sourav-kanta/minimal_watch_hw/ext_kicad_models/DW01A/DW01A.step

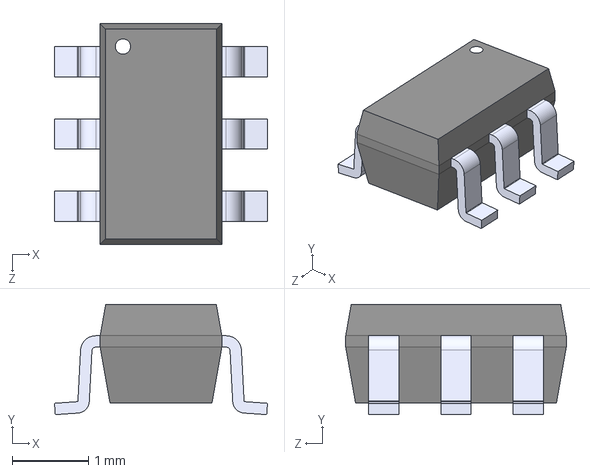
[picture p1: CAD file, 2026-02-19]
ext_kicad_models/DW01A/DW01A.step
2.80 x 1.45 x 2.90 mm
