sourav-kanta/minimal_watch_hw/ext_kicad_models/EC11B-SW-Horiz-15F-black.step

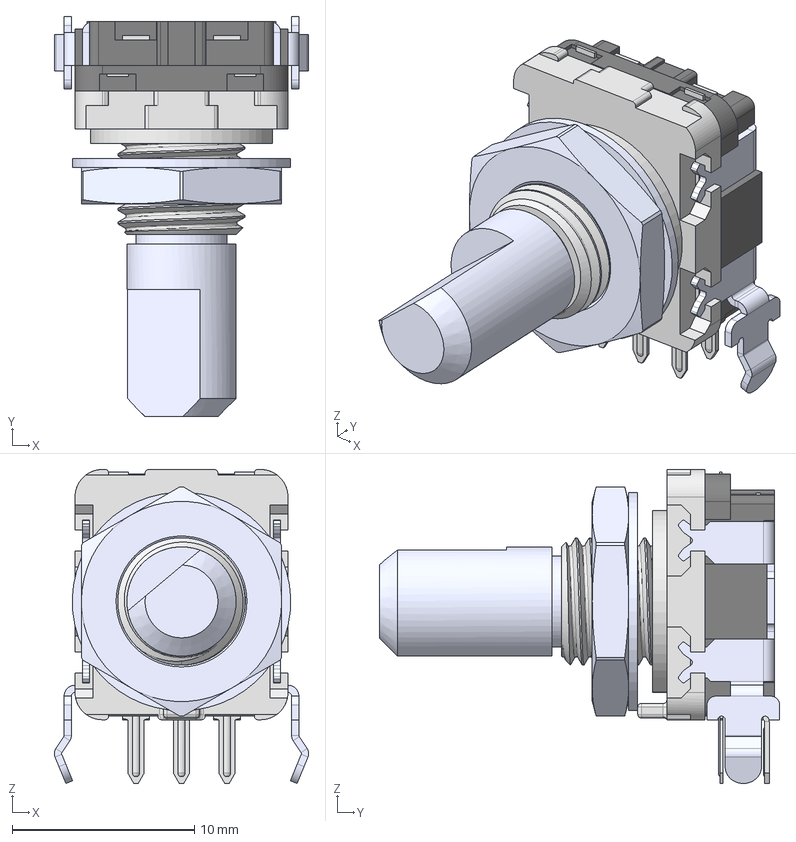
[picture p2: CAD file, 2026-03-24]
ext_kicad_models/EC11B-SW-Horiz-15F-black.step
14.0 x 22.0 x 17.3 mm
