sourav-kanta/minimal_watch_hw/ext_kicad_models/FS8205A/FS8205A.step

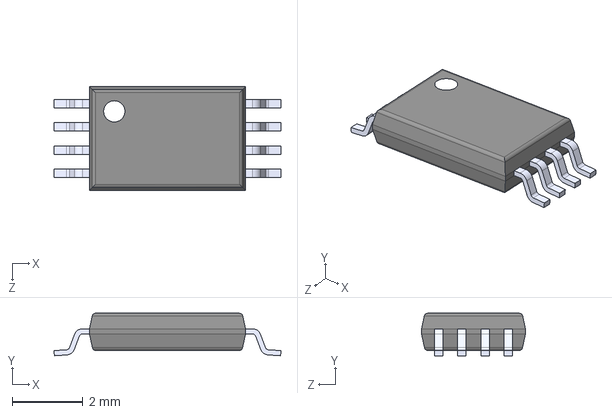
[picture p3: CAD file, 2026-02-19]
ext_kicad_models/FS8205A/FS8205A.step
6.40 x 1.20 x 2.93 mm
