sourav-kanta/minimal_watch_hw/ext_kicad_models/right_angle_switch/EVQPUC02K/3D/EVQPUC02K.stp

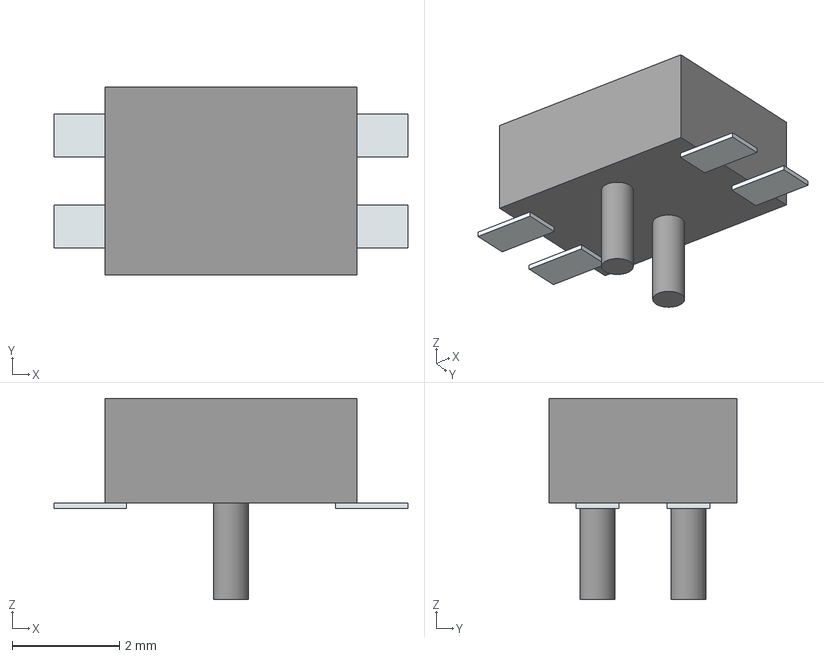
[picture p4: CAD file, 2026-03-24]
ext_kicad_models/right_angle_switch/EVQPUC02K/3D/EVQPUC02K.stp
6.60 x 3.50 x 3.75 mm
Pins
Lugs x 2
