sourav-kanta/minimal_watch_hw/ext_kicad_models/SI1016X_T1_GE3/SOT_X-T1-GE3_VIS.step

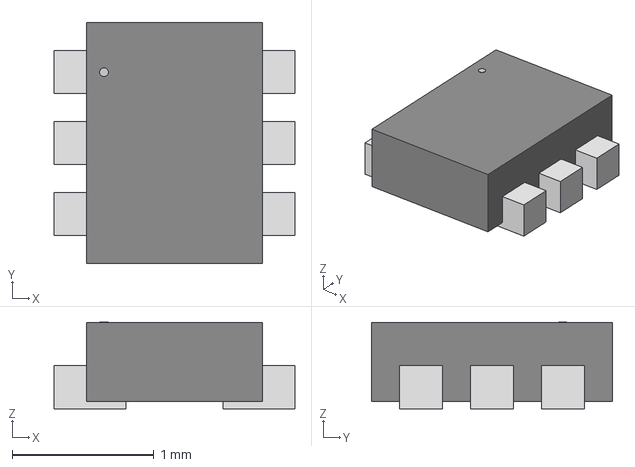
[picture p5: CAD file, 2026-02-19]
ext_kicad_models/SI1016X_T1_GE3/SOT_X-T1-GE3_VIS.step
1.70 x 1.70 x 0.612 mm
