sourav-kanta/minimal_watch_hw/ext_kicad_models/EC11B-SW-Horiz-25R-black.step

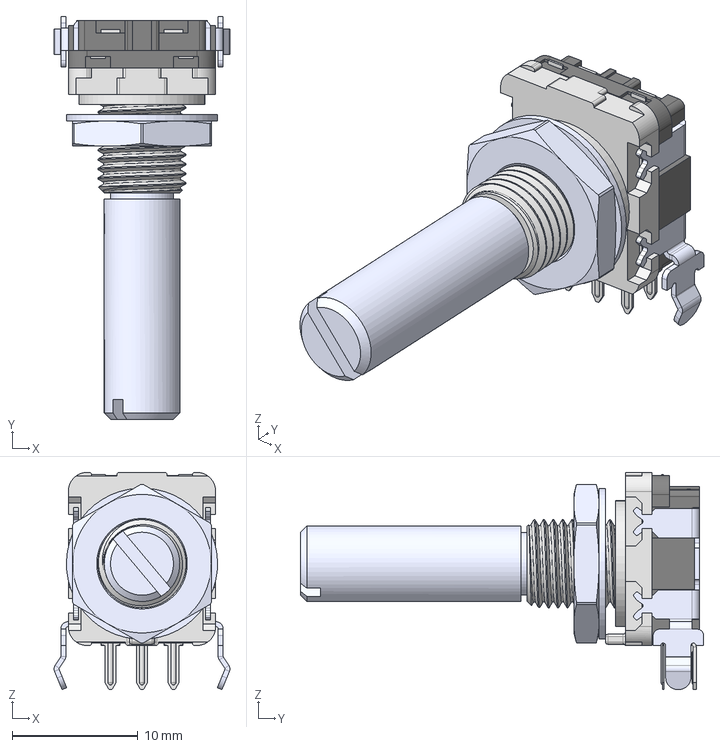
[picture p6: CAD file, 2026-03-24]
ext_kicad_models/EC11B-SW-Horiz-25R-black.step
14.0 x 32.0 x 17.3 mm
