sourav-kanta/minimal_watch_hw/ext_kicad_models/TPS63000.STEP

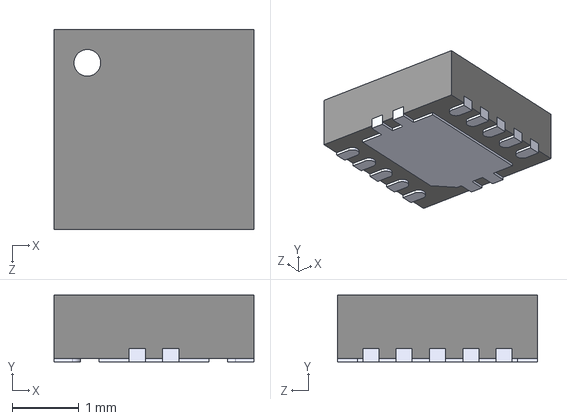
[picture p7: CAD file, 2026-02-19]
ext_kicad_models/TPS63000.STEP
3.00 x 1.00 x 3.00 mm
