sourav-kanta/minimal_watch_hw/v1/v1.kicad_pcb

## KiCad design v1/v1.kicad_pcb (2026-03-24)

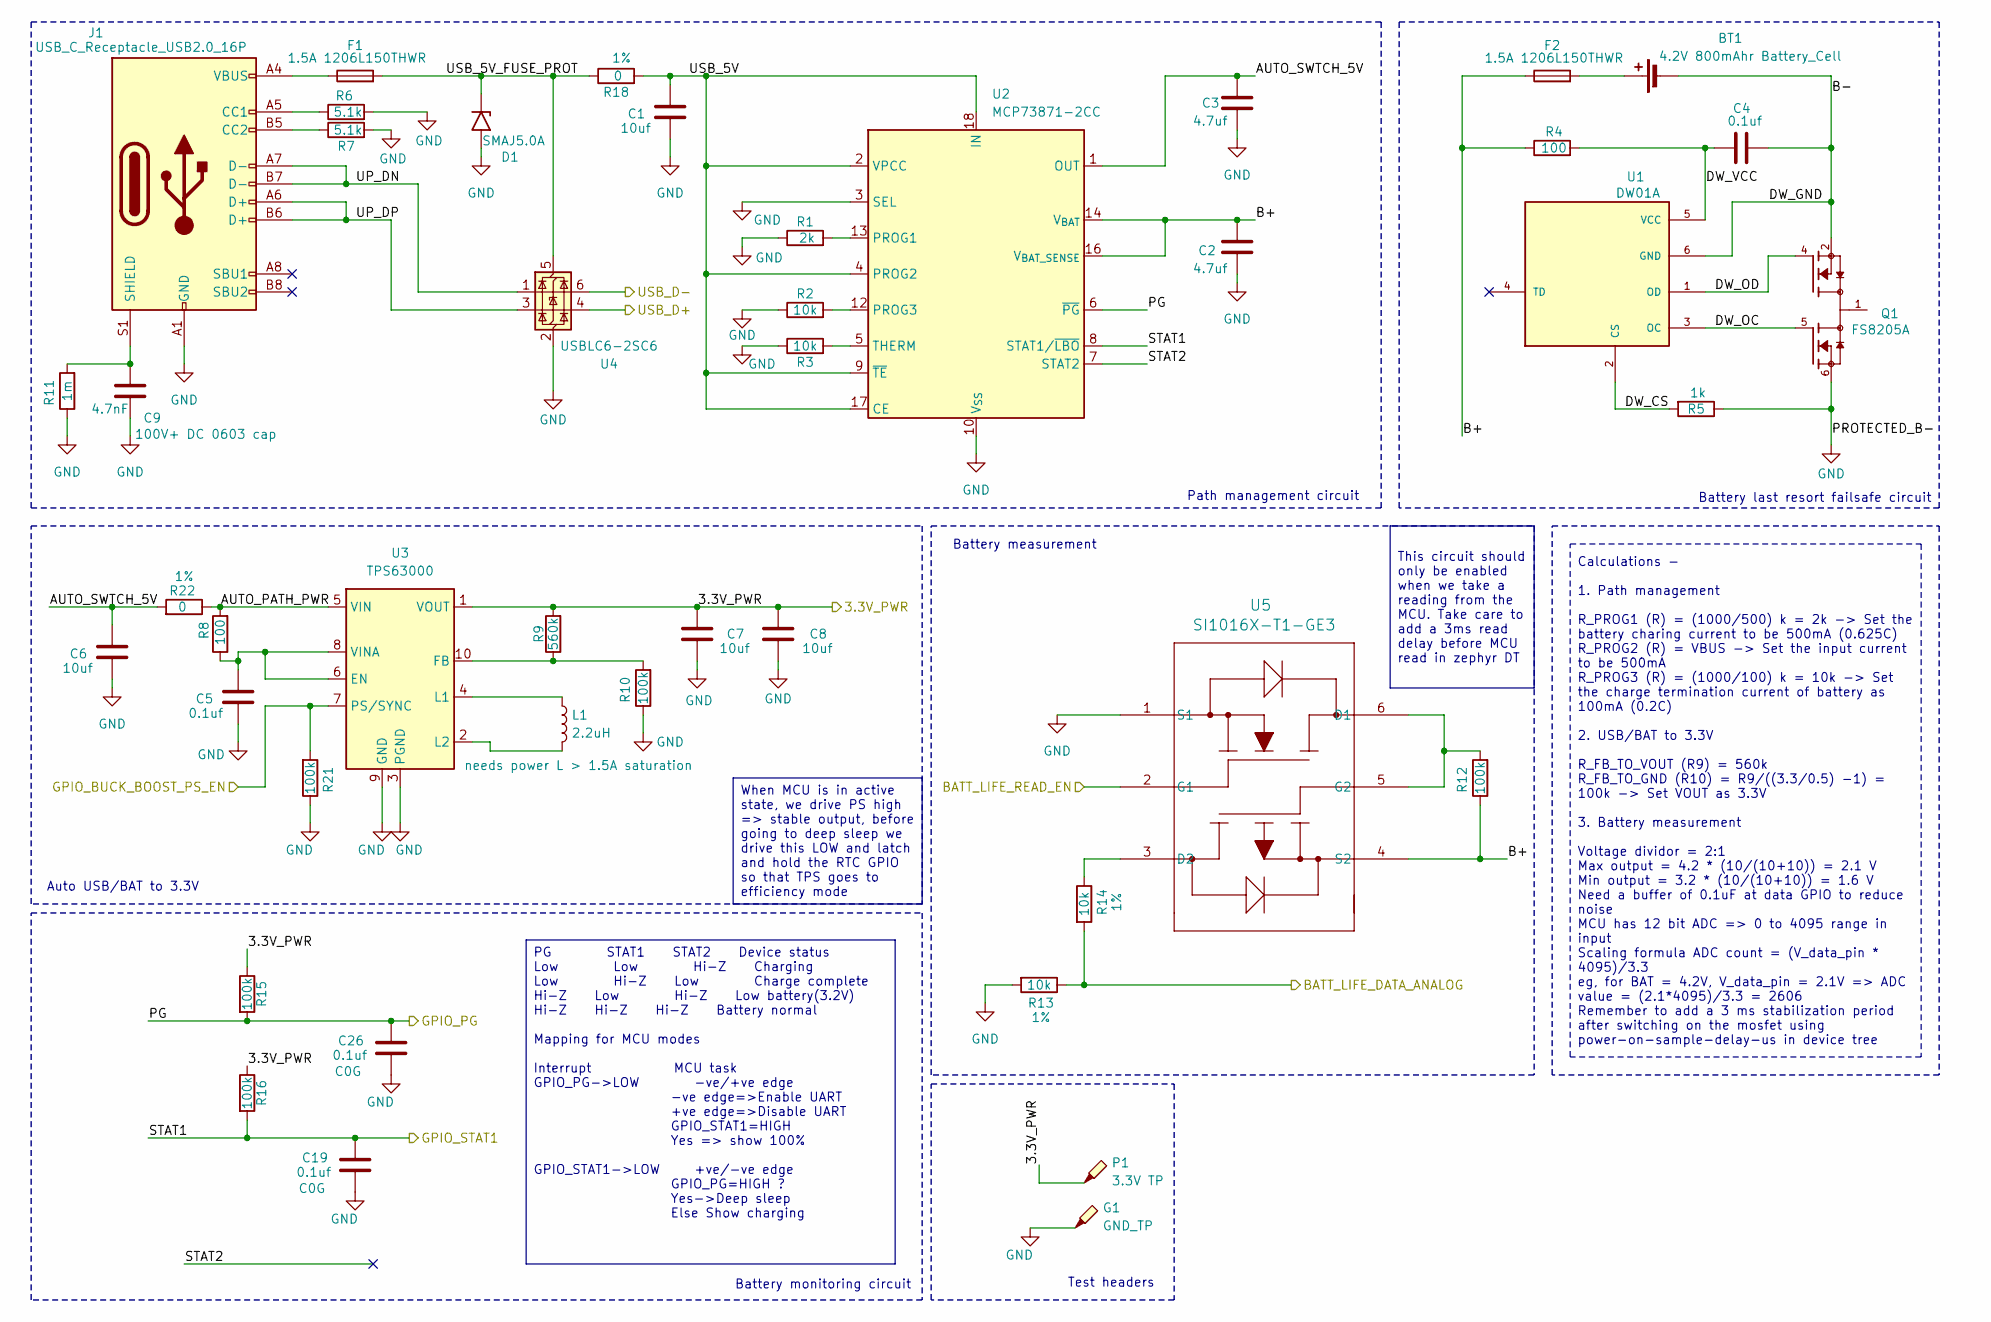
[picture p8: schematic pm.kicad_sch, Power management and BAT protection]

Parts:
BT1: 4.2V 800mAhr Battery_Cell; 4.2v_battery_mount
C1, C6, C7, C8: 10uf; C_0603_1608Metric
C2, C3: 4.7uf; C_0603_1608Metric
C4, C5: 0.1uf; C_0603_1608Metric
C9: 4.7nF; C_1210_3225Metric_Pad1.33x2.70mm_HandSolder
C19, C26: 0.1uf; C_0402_1005Metric_Pad0.74x0.62mm_HandSolder
D1: SMAJ5.0A; D_SMA
F1, F2: 1.5A 1206L150THWR; Fuse_1206_3216Metric
G1: GND_TP; TestPoint_Pad_D2.5mm
J1: USB_C_Receptacle_USB2.0_16P; USB_C_Receptacle_HRO_TYPE-C-31-M-12
L1: 2.2uH; L_Sunlord_SWPA4030S
P1: 3.3V TP; TestPoint_Pad_D2.5mm
Q1: FS8205A; SOP65P640X120-8N; PARTREV 1.7
R1: 2k; R_0603_1608Metric_Pad0.98x0.95mm_HandSolder
R2, R3, R13, R14: 10k; R_0603_1608Metric_Pad0.98x0.95mm_HandSolder
R4, R8: 100; R_0603_1608Metric_Pad0.98x0.95mm_HandSolder
R5: 1k; R_0603_1608Metric_Pad0.98x0.95mm_HandSolder
R6, R7: 5.1k; R_0603_1608Metric_Pad0.98x0.95mm_HandSolder
R9: 560k; R_0603_1608Metric_Pad0.98x0.95mm_HandSolder
R10, R12, R15, R16, R21: 100k; R_0603_1608Metric_Pad0.98x0.95mm_HandSolder
R11: 1m; R_0603_1608Metric_Pad0.98x0.95mm_HandSolder
R18, R22: 0; R_0603_1608Metric_Pad0.98x0.95mm_HandSolder
U1: DW01A; SOT95P280X145-6N; PARTREV 1.8
U2: MCP73871-2CC; QFN-20-1EP_4x4mm_P0.5mm_EP2.5x2.5mm
U3: TPS63000; Texas_DRC0010J_ThermalVias
U4: USBLC6-2SC6; SOT-23-6
U5: SI1016X-T1-GE3; SOT_X-T1-GE3_VIS-M

Connections:
/MCU/BATT_READ_DATA_ANALOG: R13.1, R14.2; also elsewhere on the board
/MCU/BAT_READ_ENABLE: U5.2 (G1); also elsewhere on the board
/MCU/PROTECTED_USB_D+: U4.4 (I/O2); also elsewhere on the board
/MCU/PROTECTED_USB_D-: U4.6 (I/O1); also elsewhere on the board
/MCU/PWR_EFFICIENCY_MODE: R21.2, U3.7 (PS/SYNC); also elsewhere on the board
/Power Module/3.3V_PWR: C7.1, C8.1, P1.1, R9.2, R15.1, R16.1, U3.1 (VOUT); also elsewhere on the board
/Power Module/AUTO_PATH_PWR: R8.2, R22.1, U3.5 (VIN)
/Power Module/AUTO_SWTCH_5V: C3.1, C6.1, R22.2, U2.1 (OUT), U2.20 (OUT)
/Power Module/B+: C2.1, F2.1, R4.1, R12.1, U2.14 (V_{BAT}), U2.15 (V_{BAT}), U2.16 (V_{BAT_SENSE}), U5.4 (S2)
/Power Module/B-: BT1.1 (-), C4.1, Q1.2, Q1.3, U1.6 (GND)
/Power Module/DW_CS: R5.2, U1.2 (CS)
/Power Module/DW_OC: Q1.5, U1.3 (OC)
/Power Module/DW_OD: Q1.4, U1.1 (OD)
/Power Module/DW_VCC: C4.2, R4.2, U1.5 (VCC)
/Power Module/PG: C26.1, R15.2, U2.6 (~PG); also elsewhere on the board
/Power Module/STAT1: C19.1, R16.2, U2.8 (STAT1/~LBO); also elsewhere on the board
/Power Module/STAT2: U2.7 (STAT2)
/Power Module/UP_DN: J1.A7 (D-), J1.B7 (D-), U4.1 (I/O1)
/Power Module/UP_DP: J1.A6 (D+), J1.B6 (D+), U4.3 (I/O2)
/Power Module/USB_5V: C1.1, R18.2, U2.2 (VPCC), U2.4 (PROG2), U2.9 (~TE), U2.17 (CE), U2.18 (IN), U2.19 (IN)
/Power Module/USB_5V_FUSE_PROT: D1.1 (A1), F1.2, R18.1, U4.5 (VBUS)
GND: C1.2, C2.2, C3.2, C5.2, C6.2, C7.2, C8.2, C9.2, C19.2, C26.2, D1.2 (A2), G1.1, J1.A1 (GND), J1.A12 (GND), J1.B1 (GND), J1.B12 (GND), Q1.6, Q1.7, R1.1, R2.1, R3.1, R5.1, R6.2, R7.2, R10.1, R11.1, R13.2, R21.1, U2.3 (SEL), U2.10 (V_{SS}), U2.11 (V_{SS}), U2.21 (V_{SS}), U3.3 (PGND), U3.9 (GND), U3.11 (PGND), U4.2 (GND), U5.1 (S1); also elsewhere on the board
unnamed: BT1.2 (+), F2.2
unnamed: F1.1, J1.A4 (VBUS), J1.A9 (VBUS), J1.B4 (VBUS), J1.B9 (VBUS)
unnamed: J1.A5 (CC1), R6.1
unnamed: J1.B5 (CC2), R7.1
unnamed: C9.1, J1.S1 (SHIELD), R11.2
unnamed: Q1.1, Q1.8
unnamed: R1.2, U2.13 (PROG1)
unnamed: R2.2, U2.12 (PROG3)
unnamed: R3.2, U2.5 (THERM)
unnamed: C5.1, R8.1, U3.6 (EN), U3.8 (VINA)
unnamed: R9.1, R10.2, U3.10 (FB)
unnamed: L1.1, U3.4 (L1)
unnamed: L1.2, U3.2 (L2)
unnamed: R12.2, U5.5 (G2), U5.6 (D1)
unnamed: R14.1, U5.3 (D2)

Notes on the sheet:
Path management circuit
Battery measurement
Test headers
Battery last resort failsafe circuit
Battery monitoring circuit
Auto USB/BAT to 3.3V
PG STAT1 STAT2 Device status Low Low Hi-Z Charging Low Hi-Z Low Charge complete Hi-Z Low Hi-Z Low battery(3.2V) Hi-Z Hi-Z Hi-Z Battery normal Mapping for MCU modes Interrupt MCU task GPIO_PG->LOW -ve/+ve edge -ve edge=>Enable UART +ve edge=>Disable UART GPIO_STAT1=HIGH Yes => show 100% GPIO_STAT1->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
Calculations - 1. Path management R_PROG1 (R) = (1000/500) k = 2k -> Set the battery charing current to be 500mA (0.625C) R_PROG2 (R) = VBUS -> Set the input current to be 500mA R_PROG3 (R) = (1000/100) k = 10k -> Set the charge termination current of battery as 100mA (0.2C) 2. USB/BAT to 3.3V R_FB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
When MCU is in active state, we drive PS high => stable output, before going to deep sleep we drive this LOW and latch and hold the RTC GPIO so that TPS goes to efficiency mode
This circuit should only be enabled when we take a reading from the MCU. Take care to add a 3ms read delay before MCU read in zephyr DT

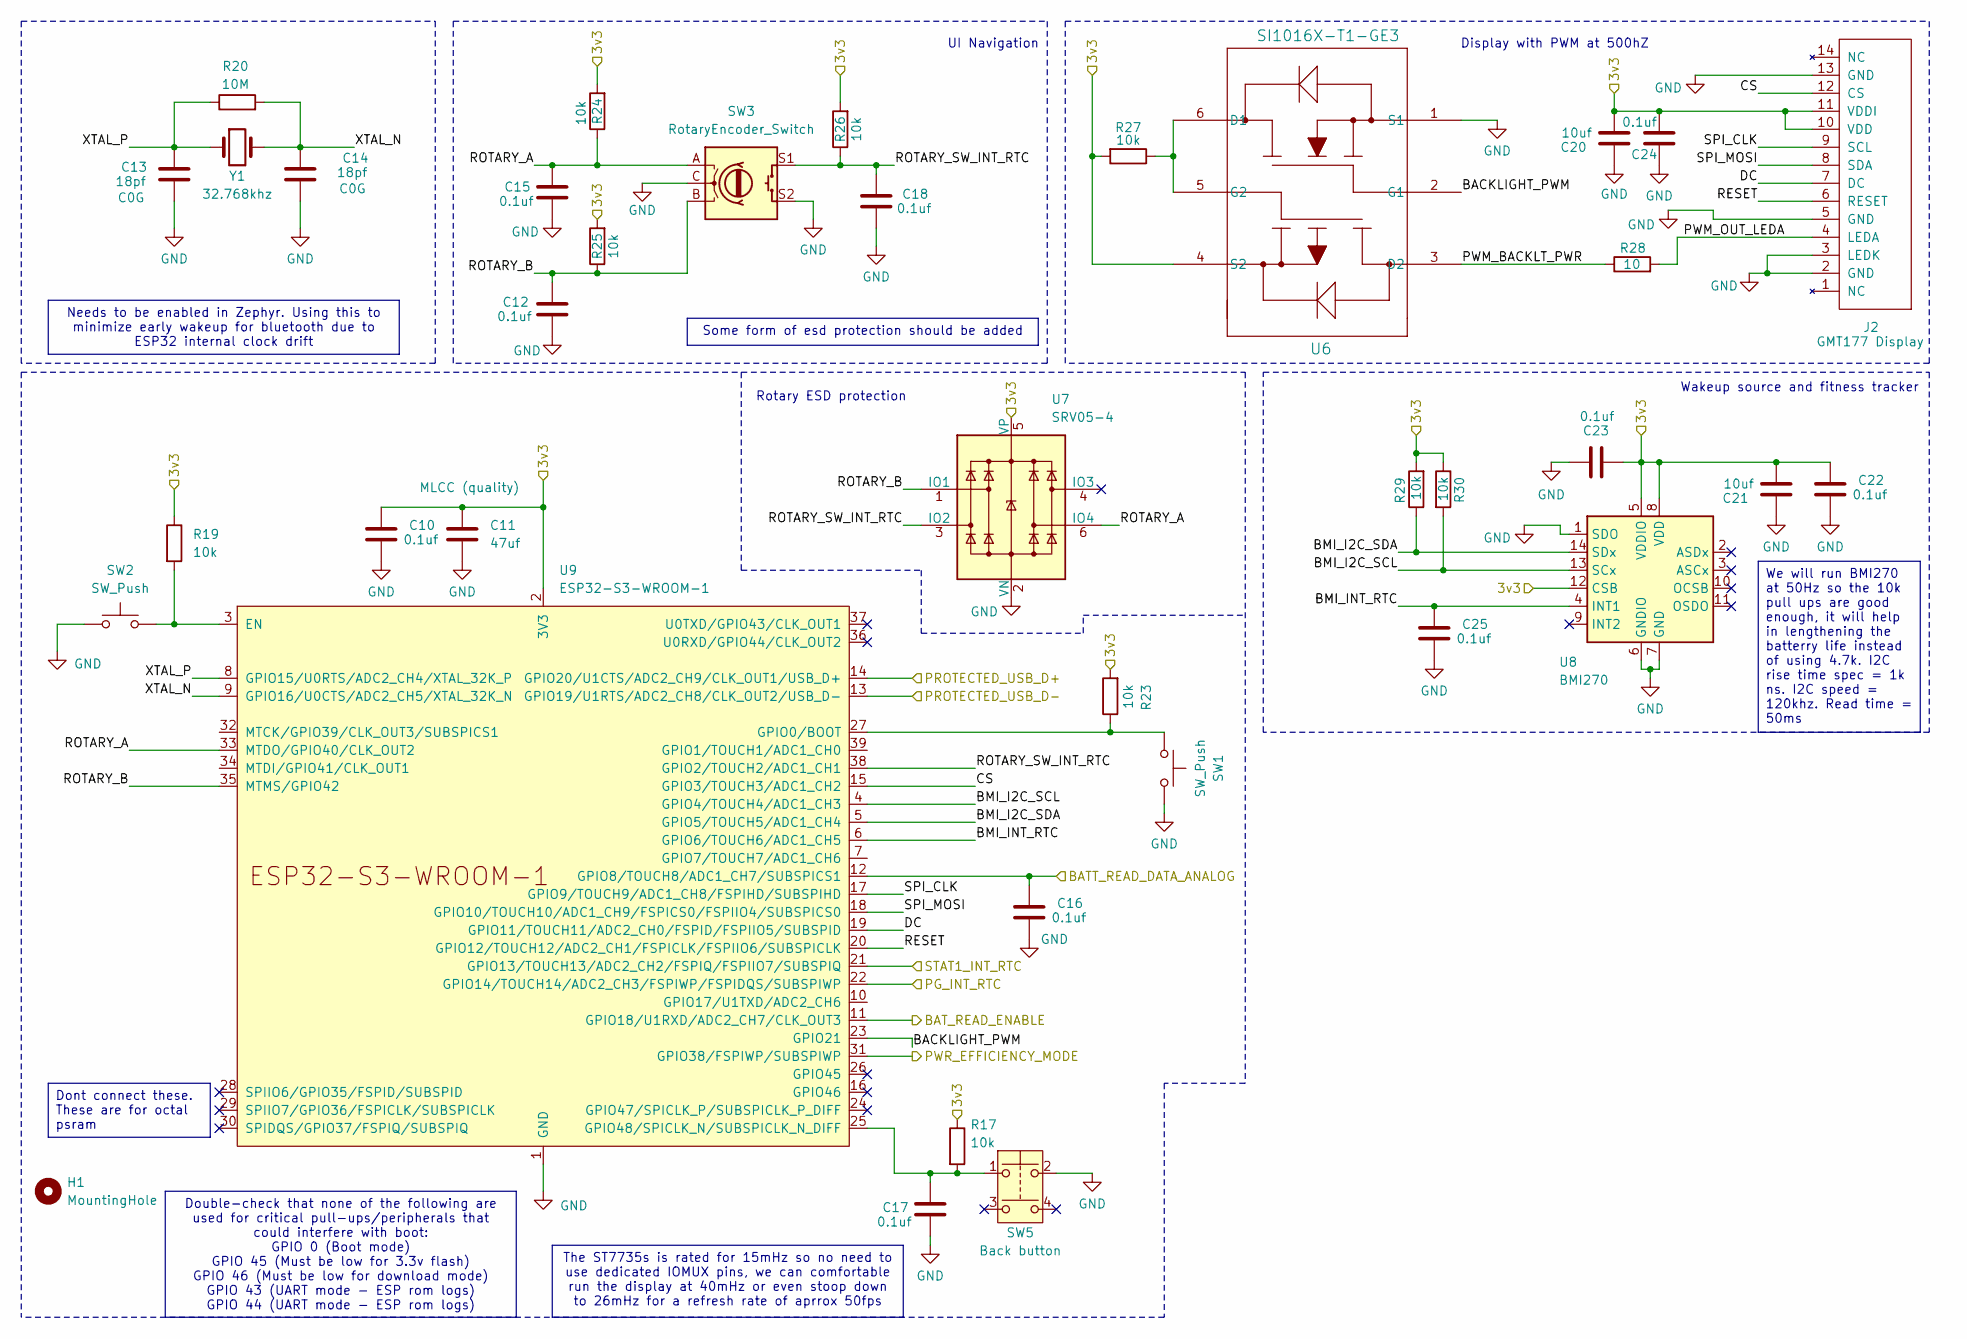
[picture p9: schematic MCU.kicad_sch]

Parts:
C10, C12, C15, C16, C17, C18, C22, C23, C24, C25: 0.1uf; C_0603_1608Metric_Pad1.08x0.95mm_HandSolder
C11: 47uf; C_1210_3225Metric_Pad1.33x2.70mm_HandSolder
C13, C14: 18pf; C_0402_1005Metric_Pad0.74x0.62mm_HandSolder
C20, C21: 10uf; C_0603_1608Metric_Pad1.08x0.95mm_HandSolder
H1: MountingHole; MountingHole_3.2mm_M3_ISO14580
J2: GMT177 Display; TE_1-1734839-3_1x13-1MP_P0.5mm_Horizontal
R17, R19, R23, R24, R25, R26, R27, R29, R30: 10k; R_0603_1608Metric_Pad0.98x0.95mm_HandSolder
R20: 10M; R_0603_1608Metric_Pad0.98x0.95mm_HandSolder
R28: 10; R_0603_1608Metric_Pad0.98x0.95mm_HandSolder
SW1, SW2: SW_Push; SW_SPST_B3U-1000P
SW3: RotaryEncoder_Switch; RotaryEncoder_Bourns_Horizontal_PEC12R-2x17F-Sxxxx
SW5: Back button; EVQPUC02K
U6: SI1016X-T1-GE3; SOT_X-T1-GE3_VIS-M
U7: SRV05-4; SOT-23-6
U8: BMI270; Bosch_LGA-14_3x2.5mm_P0.5mm
U9: ESP32-S3-WROOM-1
Y1: 32.768khz; Crystal_SMD_3215-2Pin_3.2x1.5mm

Connections:
/MCU/BACKLIGHT_PWM: U6.2 (G1), U9.23 (GPIO21)
/MCU/BATT_READ_DATA_ANALOG: C16.1, U9.12 (GPIO8/TOUCH8/ADC1_CH7/SUBSPICS1); also elsewhere on the board
/MCU/BAT_READ_ENABLE: U9.11 (GPIO18/U1RXD/ADC2_CH7/CLK_OUT3); also elsewhere on the board
/MCU/BMI_I2C_SCL: R30.2, U8.13 (SCx), U9.4 (GPIO4/TOUCH4/ADC1_CH3)
/MCU/BMI_I2C_SDA: R29.1, U8.14 (SDx), U9.5 (GPIO5/TOUCH5/ADC1_CH4)
/MCU/BMI_INT_RTC: C25.1, U8.4 (INT1), U9.6 (GPIO6/TOUCH6/ADC1_CH5)
/MCU/CS: J2.12 (CS), U9.15 (GPIO3/TOUCH3/ADC1_CH2)
/MCU/DC: J2.7 (DC), U9.19 (GPIO11/TOUCH11/ADC2_CH0/FSPID/FSPIIO5/S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)
/MCU/PROTECTED_USB_D+: U9.14 (GPIO20/U1CTS/ADC2_CH9/CLK_OUT1/USB_D+); also elsewhere on the board
/MCU/PROTECTED_USB_D-: U9.13 (GPIO19/U1RTS/ADC2_CH8/CLK_OUT2/USB_D-); also elsewhere on the board
/MCU/PWM_BACKLT_PWR: R28.1, U6.3 (D2)
/MCU/PWM_OUT_LEDA: J2.4 (LEDA), R28.2
/MCU/PWR_EFFICIENCY_MODE: U9.31 (GPIO38/FSPIWP/SUBSPIWP); also elsewhere on the board
/MCU/RESET: J2.6 (RESET), U9.20 (GPIO12/TOUCH12/ADC2_CH1/FSPICLK/FSPIIO6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)
/MCU/ROTARY_A: C15.1, R24.1, SW3.A, U7.6 (IO4), U9.33 (MTDO/GPIO40/CLK_OUT2)
/MCU/ROTARY_B: C12.1, R25.1, SW3.B, U7.1 (IO1), U9.35 (MTMS/GPIO42)
/MCU/ROTARY_SW_INT_RTC: C18.1, R26.1, SW3.S1, U7.3 (IO2), U9.38 (GPIO2/TOUCH2/ADC1_CH1)
/MCU/SPI_CLK: J2.9 (SCL), U9.17 (GPIO9/TOUCH9/ADC1_CH8/FSPIHD/SUBSPIHD)
/MCU/SPI_MOSI: J2.8 (SDA), U9.18 (GPIO10/TOUCH10/ADC1_CH9/FSPICS0/FSPIIO4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)
/MCU/XTAL_N: C14.1, R20.2, U9.9 (GPIO16/U0CTS/ADC2_CH5/XTAL_32K_N), Y1.2
/MCU/XTAL_P: C13.1, R20.1, U9.8 (GPIO15/U0RTS/ADC2_CH4/XTAL_32K_P), Y1.1
/Power Module/3.3V_PWR: C10.1, C11.1, C20.2, C21.2, C22.1, C23.2, C24.1, J2.10 (VDD), J2.11 (VDDI), R17.1, R19.1, R23.2, R24.2, R25.2, R26.2, R27.2, R29.2, R30.1, U6.4 (S2), U7.5 (VP), U8.5 (VDDIO), U8.8 (VDD), U8.12 (CSB), U9.2 (3V3); also elsewhere on the board
/Power Module/PG: U9.22 (GPIO14/TOUCH14/ADC2_CH3/FSPIWP/FSPIDQS/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); also elsewhere on the board
/Power Module/STAT1: U9.21 (GPIO13/TOUCH13/ADC2_CH2/FSPIQ/FSPIIO7/S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); also elsewhere on the board
GND: C10.2, C11.2, C12.2, C13.2, C14.2, C15.2, C16.2, C17.2, C18.2, C20.1, C21.1, C22.2, C23.1, C24.2, C25.2, J2.2 (GND), J2.3 (LEDK), J2.5 (GND), J2.13 (GND), SW1.2, SW2.1, SW3.C, SW3.S2, SW5.2, U6.1 (S1), U7.2 (VN), U8.1 (SDO), U8.6 (GNDIO), U8.7 (GND), U9.1 (GND), U9.40 (GND), U9.41 (GND); also elsewhere on the board
unnamed: R27.1, U6.5 (G2), U6.6 (D1)
unnamed: R19.2, SW2.2, U9.3 (EN)
unnamed: R23.1, SW1.1, U9.27 (GPIO0/BOOT)
unnamed: C17.1, R17.2, SW5.1, U9.25 (GPIO48/SPICLK_N/SUBSPICLK_N_DIFF)

Notes on the sheet:
Rotary ESD protection
Wakeup source and fitness tracker
Display with PWM at 500hZ
UI Navigation
Some form of esd protection should be added
We will run BMI270 at 50Hz so the 10k pull ups are good enough, it will help in lengthening the batterry life instead of using 4.7k. I2C rise time spec = 1k ns. I2C speed = 120khz. Read time = 50ms
The ST7735s is rated for 15mHz so no need to use dedicated IOMUX pins, we can comfortable run the display at 40mHz or even stoop down to 26mHz for a refresh rate of aprrox 50fps
Dont connect these. These are for octal psram
Needs to be enabled in Zephyr. Using this to minimize early wakeup for bluetooth due to ESP32 internal clock drift
Double-check that none of the following are used for critical pull-ups/peripherals that could interfere with boot: GPIO 0 (Boot mode) GPIO 45 (Must be low for 3.3v flash) GPIO 46 (Must be low for download mode) GPIO 43 (UART mode - ESP rom logs) GPIO 44 (UART mode - ESP rom logs)

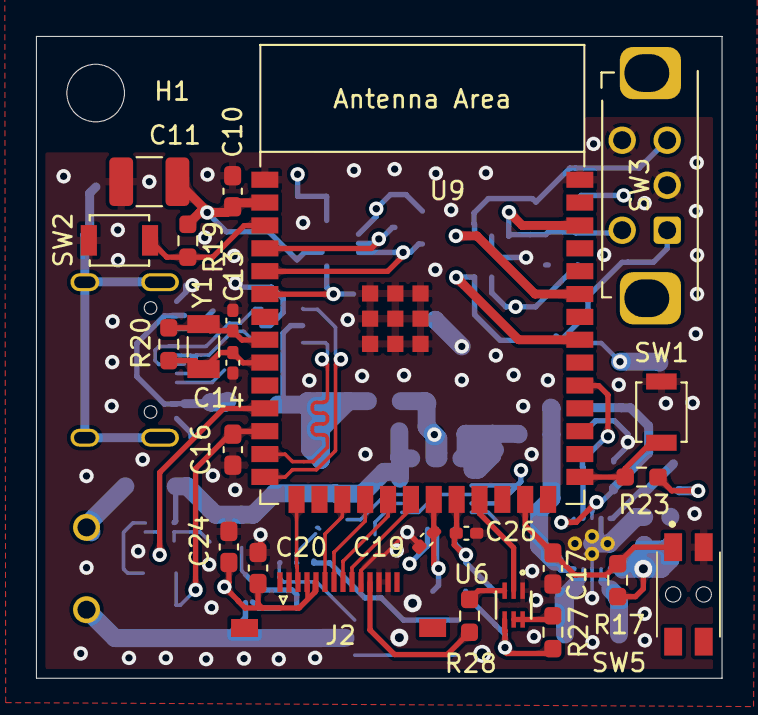
[picture p10: board v1.kicad_pcb from above]

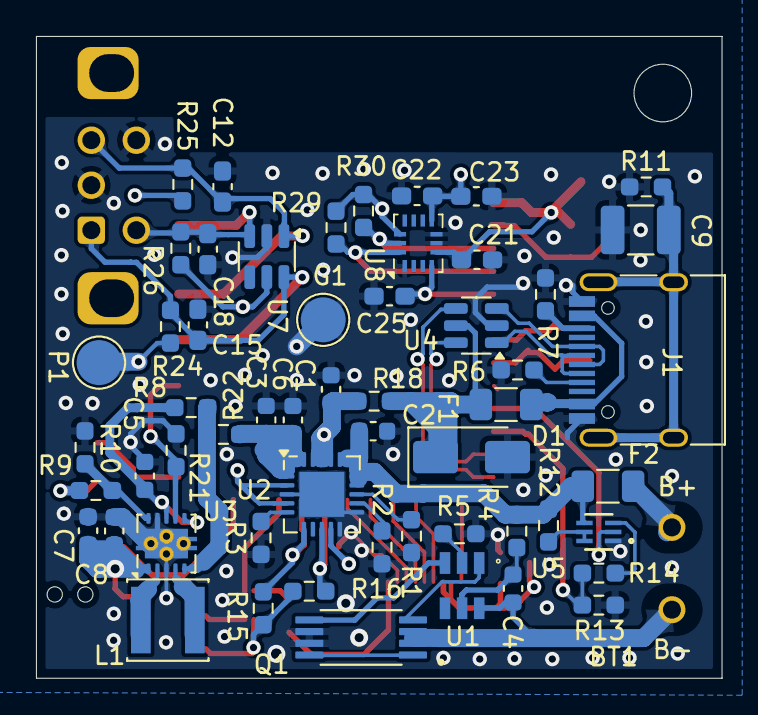
[picture p11: board v1.kicad_pcb from below]

Board: 4 copper layers, 38.1 x 35.7 mm, 81 parts (56 on the bottom side), 56 nets.
