sourav-kanta/minimal_watch_hw/(commit log)

2026-02-19 Missing files
    [MCU.kicad_sch]
2026-02-19 Missing files 2.0
    [v1.kicad_pcb]
2026-03-24 Updated layout
    [EC11B-SW-Horiz-15F-black.step, EC11B-SW-Horiz-25R-black.step, MCU.kicad_sch, pm.kicad_sch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]
2026-03-24 Updated schematics with relative paths
    [EVQPUC02K.stp, MCU.kicad_sch, v1.kicad_pcb]
